Andreas-Ley/appcvrobot_electronics/mainboard/CurrentVoltageResistorTest.ods

 | I | V1 | V2 | Vout | R1 | R2 | R3 | R4
0 | 0 | 2.5 | 5 | 0.35 | 10 | 33 | 33 | 22
1 | 0.3125 | 2.4421875 | 5 | 0.540781249999998
2 | 0.625 | 2.384375 | 5 | 0.731562499999999
3 | 0.9375 | 2.3265625 | 5 | 0.92234375
4 | 1.25 | 2.26875 | 5 | 1.113125
5 | 1.5625 | 2.2109375 | 5 | 1.30390625
6 | 1.875 | 2.153125 | 5 | 1.4946875
7 | 2.1875 | 2.0953125 | 5 | 1.68546875
8 | 2.5 | 2.0375 | 5 | 1.87625
9 | 2.8125 | 1.9796875 | 5 | 2.06703125
10 | 3.125 | 1.921875 | 5 | 2.2578125
11 | 3.4375 | 1.8640625 | 5 | 2.44859375
12 | 3.75 | 1.80625 | 5 | 2.639375
13 | 4.0625 | 1.7484375 | 5 | 2.83015625
14 | 4.375 | 1.690625 | 5 | 3.0209375
15 | 4.6875 | 1.6328125 | 5 | 3.21171875
16 | 5 | 1.575 | 5 | 3.4025
