Andreas-Ley/appcvrobot_electronics/(commit log)

2019-09-24 Board split into main and power. Proper voltage difference forming to get cell voltages. current measurement.
    [AppCVRobot.kicad_pcb, AppCVRobot.sch, CurrentVoltageResistorTest.ods]
2019-09-26 Added levelshifter for LCD display
    [AppCVRobot.kicad_pcb, AppCVRobot.sch]
2019-09-29 Various fixes/mods while building
    [AppCVRobot.kicad_pcb, AppCVRobot.sch]
2019-10-02 Added power switch connector
    [AppCVRobot.kicad_pcb, AppCVRobot.sch]
2020-02-25 main changes
    [AppCVRobot.kicad_pcb, CurrentVoltageResistorTest.ods, main.kicad_pcb, main.sch, power.kicad_pcb, power.sch]
2020-02-27 first prototype
    [main.kicad_pcb, main.sch]
2020-02-27 pwm pins
    [main.kicad_pcb, main.sch]
2020-02-27 larger capacitor footprints
    [main.kicad_pcb, main.sch]
2020-03-04 Mainboard changes
    [main.kicad_pcb, main.sch]
2020-03-05 Cleanup directory/files
    [AppCVRobot.kicad_pcb, AppCVRobot.sch, CurrentVoltageResistorTest.ods, power.kicad_pcb, power.sch]
2020-03-05 Major re-layouting and cleanup
    [main.kicad_pcb, main.sch]
2020-03-05 Minor polishing for submission
    [main.kicad_pcb, main.sch]
2020-03-06 mirrored CV&RS label, moved board outline to correct layer
    [main.kicad_pcb]
2020-03-17 Various smaller fixes
    [main.kicad_pcb, main.sch]
2020-03-17 Updated component values in layout
    [main.kicad_pcb]
2020-04-16 New power circuitry and layout
    [main.kicad_pcb, main.sch]
2020-05-30 - 200k potis for cell voltage sensing - hints on setting up the trim potis - Better layout of labels on PCB
    [main.kicad_pcb, main.sch]
